OSHPark/boards/holiday-candleholder/README.md

# Candleholder Holiday Board

It flickers. 



|Refdes|Qty|Description|Source|
|---|---|---|---|
|BATT|1|3V 20mA 20MM LITHIUM CR2032 COIN CELL|Digikey SY189-ND|
|BH1|1|CR2032 BATTERY STRAP SMT|Digikey BC-2003-TR-TR-ND|
|D1|1|Yellow 5 mm Clear Candle Flicker LED|Evil Mad Scientist 353|
|R1|1|RES 47 OHM 1/4W 5% CARBON FILM|Digikey CF14JT47R0TR-ND|
