OSHPark/boards/shift-register-demo/docs/sn54hc595-dip16.png

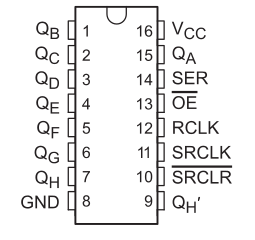
shift-register-demo/docs/sn54hc595-dip16.png
