OSHPark/boards/tokens/osh/osh.bmp

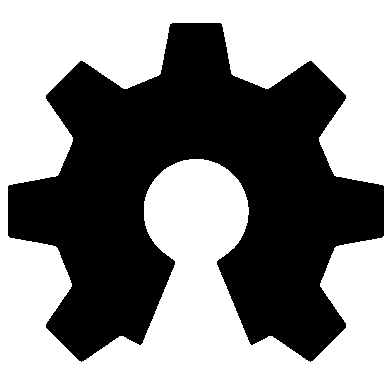
tokens/osh/osh.bmp
