OSHPark/boards/shift-register-demo/v1/shift-register-demo-v1-schematic.pdf

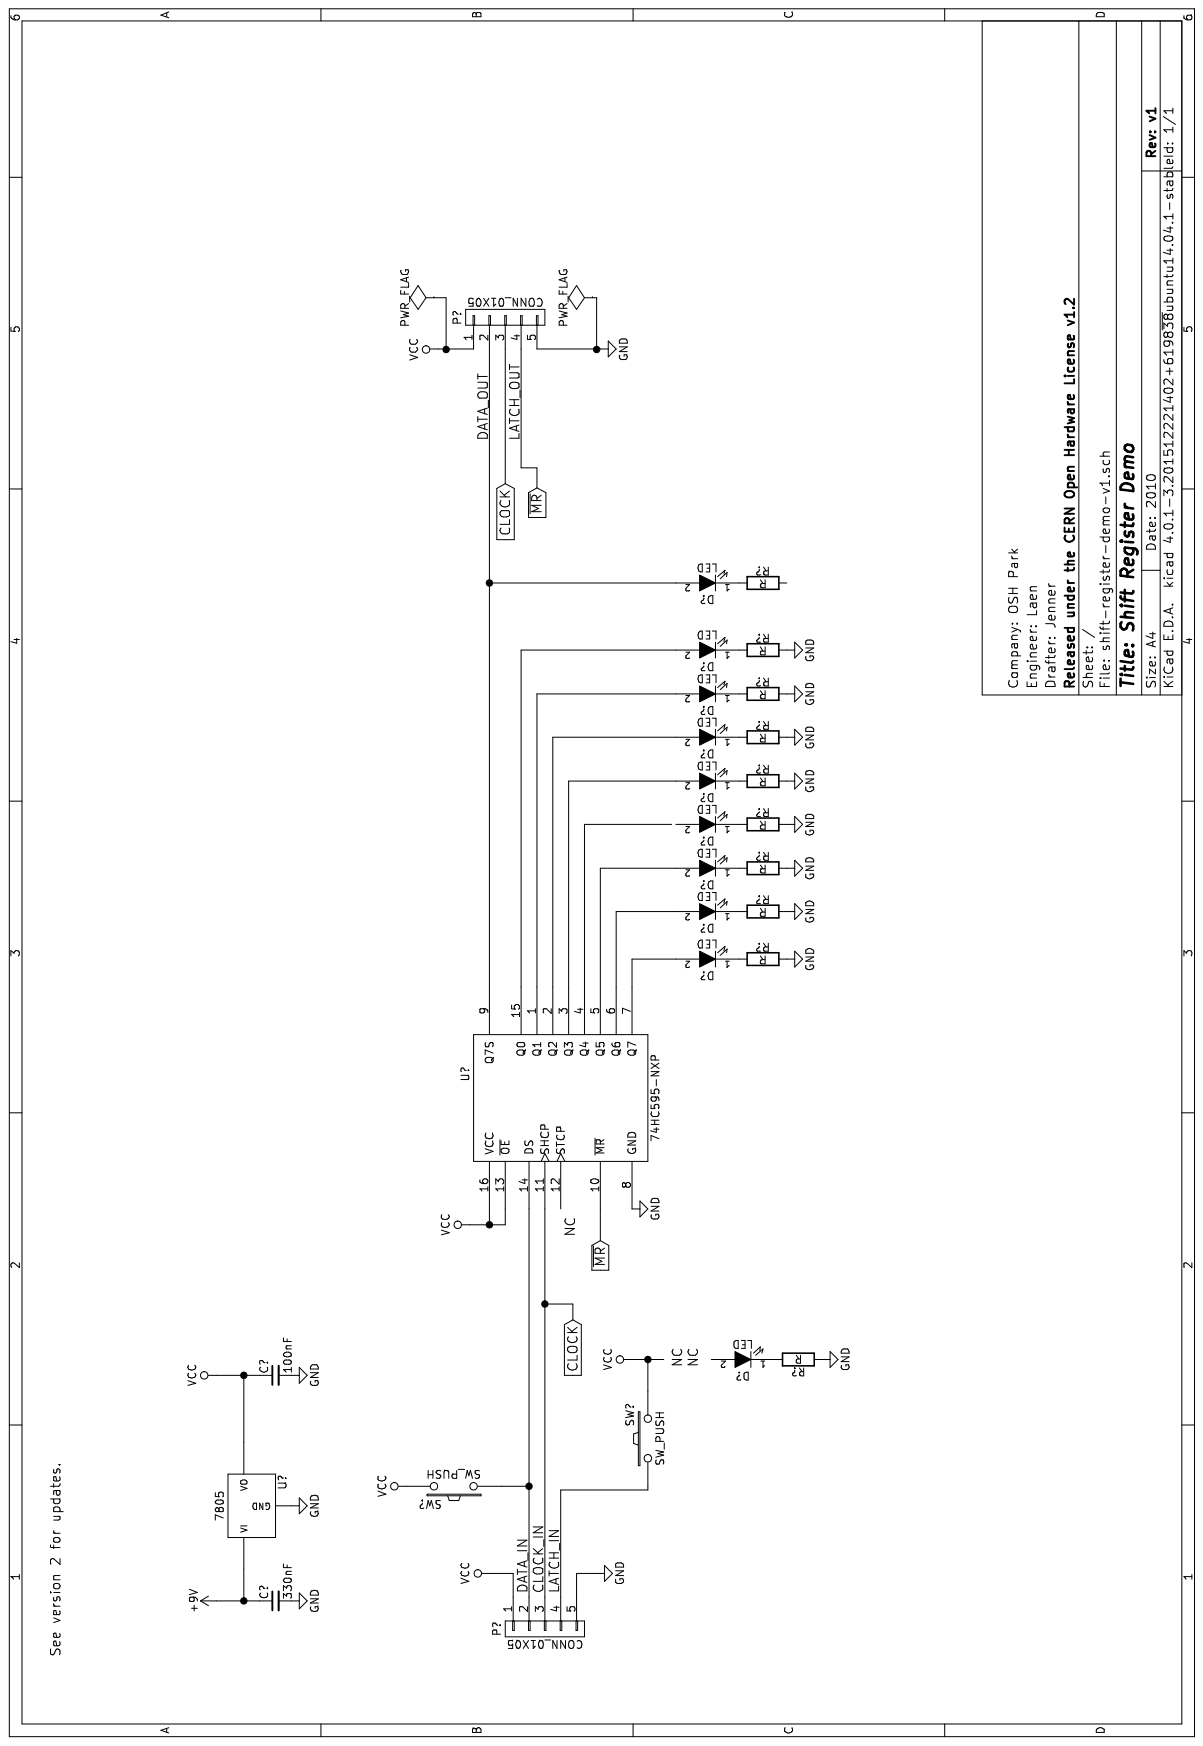
[picture p8: page 1]
