OSHPark/boards/(commit log)

2015-09-06 Added token bases and tokens with OSH symbol design.
    [base-tokens.brd, osh-tokens.brd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]
2015-10-25 Some random clipart and v1 of the board. Ordered on Oct 25.
    [holiday-candleholder.brd, holiday-candleholder.sch]
2015-11-25 Softened corner. Removed mask on front holes. Changed silk to be more waxlike.
    [holiday-candleholder.brd, holiday-candleholder.sch]
2015-12-14 Cleanup. Generated gerbers, added preview images.
    [holiday-candleholder.drills.xln, osh-tokens.drills.xln]
2016-02-09 Added the v1 of Shift Reg Demo as it is now.
    [shift-register-demo.sch]
2016-02-09 Adding v1 to name.
    [shift-register-demo-v1.sch]
2016-02-09 Added schematic PDFs.
    [shift-register-demo-v2.sch]
2016-02-09 Added v1 schematic pdf.
    [shift-register-demo-v1.sch]
2016-02-11 Need the renderer for the schematic.
    [shift-register-demo-v2.kicad_pcb, shift-register-demo-v2.sch]
2016-02-11 Placement done. Test gerbers generated.
    [shift-register-demo-v2-B.Cu.gbl, shift-register-demo-v2-B.Mask.gbs, shift-register-demo-v2-B.SilkS.gbo, shift-register-demo-v2-Edge.Cuts.gm1, shift-register-demo-v2-F.Cu.gtl, shift-register-demo-v2-F.Mask.gts, shift-register-demo-v2-F.SilkS.gto, shift-register-demo-v2.drl]
2016-02-11 Fixed up placement, added outline, added ground fill.
    [shift-register-demo-v2-B.Cu.gbl, shift-register-demo-v2-B.Mask.gbs, shift-register-demo-v2-B.SilkS.gbo, shift-register-demo-v2-Edge.Cuts.gm1, shift-register-demo-v2-F.Cu.gtl, shift-register-demo-v2-F.Mask.gts, shift-register-demo-v2-F.SilkS.gto, shift-register-demo-v2.drl]
2016-02-11 Electrically good. Needs aesthetics.
    [shift-register-demo-v2-B.Cu.gbl, shift-register-demo-v2-B.Mask.gbs, shift-register-demo-v2-B.SilkS.gbo, shift-register-demo-v2-Edge.Cuts.gm1, shift-register-demo-v2-F.Cu.gtl, shift-register-demo-v2-F.Mask.gts, shift-register-demo-v2-F.SilkS.gto, shift-register-demo-v2.drl]
2016-02-11 Shift reg v2 done, making order today.
    [shift-register-demo-v2-B.Cu.gbl, shift-register-demo-v2-B.Mask.gbs, shift-register-demo-v2-B.SilkS.gbo, shift-register-demo-v2-Edge.Cuts.gm1, shift-register-demo-v2-F.Cu.gtl, shift-register-demo-v2-F.Mask.gts, shift-register-demo-v2-F.SilkS.gto, shift-register-demo-v2.drl]
2016-02-11 Swapped out SPDT for toggle for LATCH.
    [shift-register-demo-v2-B.Cu.gbl, shift-register-demo-v2-B.Mask.gbs, shift-register-demo-v2-B.SilkS.gbo, shift-register-demo-v2-Edge.Cuts.gm1, shift-register-demo-v2-F.Cu.gtl, shift-register-demo-v2-F.Mask.gts, shift-register-demo-v2-F.SilkS.gto, shift-register-demo-v2.drl]
2016-02-15 Added RasPi MPU 9150 board and Arduino Theremin.
    [arduino-theremin-v1.kicad_pcb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]
2016-02-15 Wrong folder name.
    [raspi-mpu9150-board-v1.kicad_pcb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]
2016-03-01 Not actually sure about this commit...
    [arduino-theremin-v1-B.Cu.gbl, arduino-theremin-v1-B.Mask.gbs, arduino-theremin-v1-B.SilkS.gbo, arduino-theremin-v1-Edge.Cuts.gm1, arduino-theremin-v1-F.Cu.gtl, arduino-theremin-v1-F.Mask.gts, arduino-theremin-v1-F.SilkS.gto, arduino-theremin-v1.drl]
2016-08-17 Removed projects.
    [arduino-theremin-v1-B.Cu.gbl, arduino-theremin-v1-B.Mask.gbs, arduino-theremin-v1-B.SilkS.gbo, arduino-theremin-v1-Edge.Cuts.gm1, arduino-theremin-v1-F.Cu.gtl, arduino-theremin-v1-F.Mask.gts, arduino-theremin-v1-F.SilkS.gto, arduino-theremin-v1.drl]
2016-08-30 Dropped all debouncing.
    [shift-register-demo-v2-B.CrtYd.gbr, shift-register-demo-v2-B.Cu.gbl, shift-register-demo-v2-B.Fab.gbr, shift-register-demo-v2-B.Mask.gbs, shift-register-demo-v2-Edge.Cuts.gko, shift-register-demo-v2-F.CrtYd.gbr, shift-register-demo-v2-F.Cu.gtl, shift-register-demo-v2-F.Fab.gbr]
