OSHPark/boards/(notices)

Notices in the files:
shift-register-demo/v2/shift-register-demo-v2.sch:
Released under the CERN Open Hardware License v1.2
parts and their libraries:
SparkFun-LED: Licensing: Creative Commons ShareAlike 4.0 International - https://creativecommons.org/licenses/by-sa/4.0
PatternAgents-Logos: License : http://creativecommons.org/licenses/by-sa/3.0
(Creative Commons 3.0)
